philpownall/ESPHome-Sun-Moon-Azimuth-Tracker/docs/SunMoonTracker.png

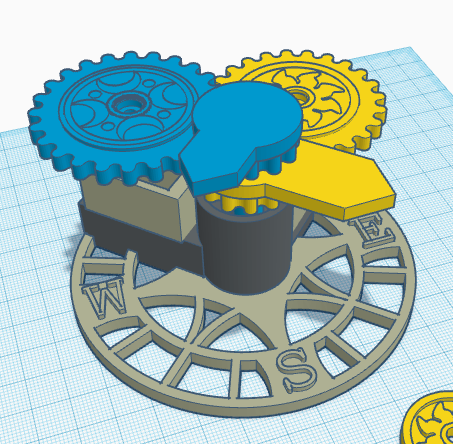
docs/SunMoonTracker.png
