philpownall/ESPHome-Sun-Moon-Azimuth-Tracker/README.md

# ESPHome-Sun-Moon-Azimuth-Tracker
 An Azimuth Tracker for the Sun and Moon

[SunMoonAzimuth.md](./docs/SunMoonAzimuth.md)
