philpownall/ESPHome-Sun-Moon-Azimuth-Tracker/2X Cog Sun.stl

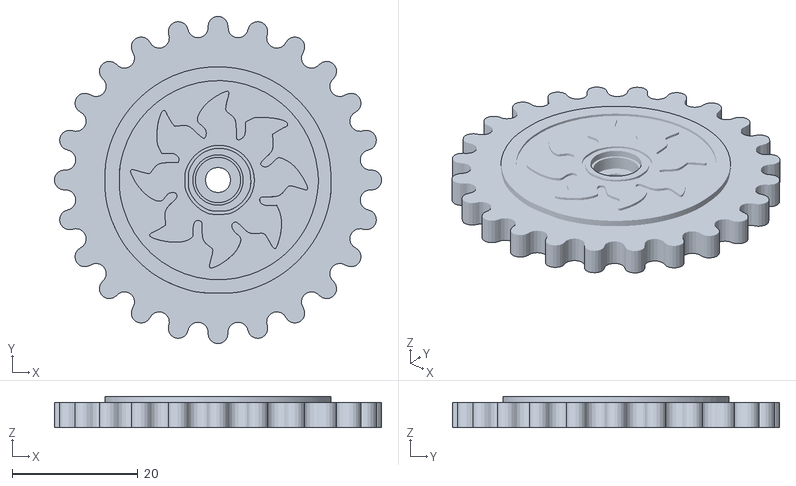
[picture p2: CAD file, 2024-05-20]
2X Cog Sun.stl
52.0 x 52.0 x 5.00
