philpownall/ESPHome-Sun-Moon-Azimuth-Tracker/Sun Cog.stl

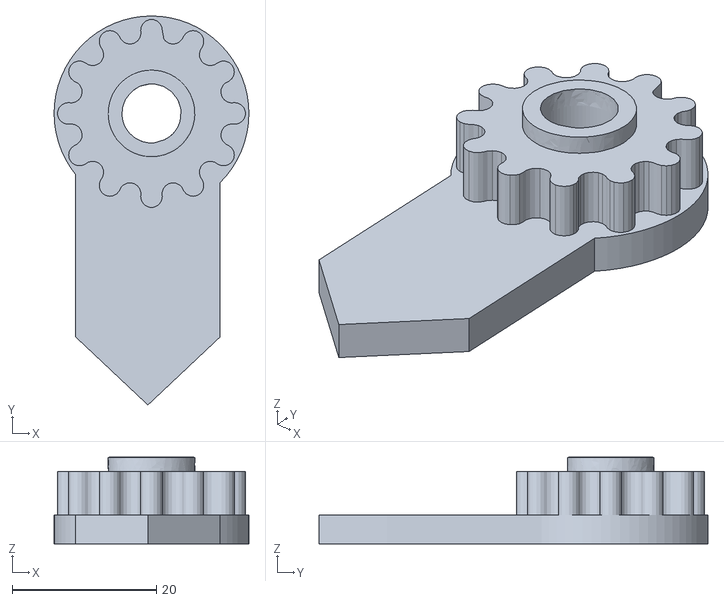
[picture p3: CAD file, 2024-05-20]
Sun Cog.stl
27.0 x 53.9 x 12.0
