philpownall/ESPHome-Sun-Moon-Azimuth-Tracker/2X Cog Moon.stl

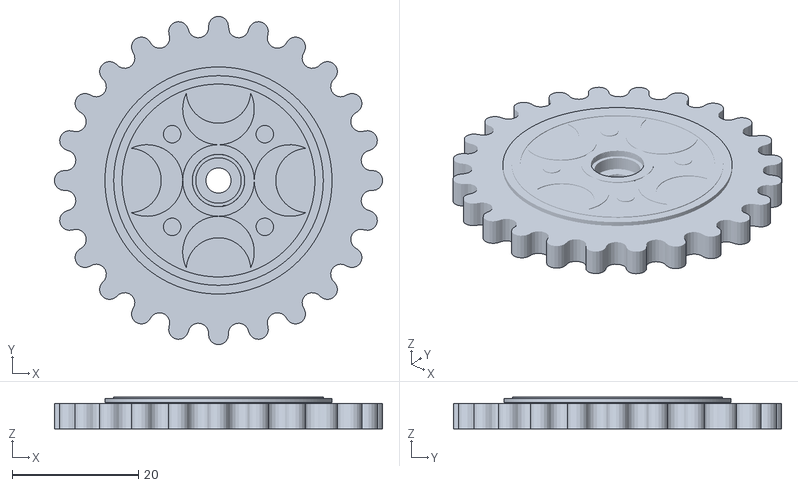
[picture p4: CAD file, 2024-05-20]
2X Cog Moon.stl
52.0 x 52.0 x 5.00
