philpownall/ESPHome-Sun-Moon-Azimuth-Tracker/SunMoonAz Base.stl

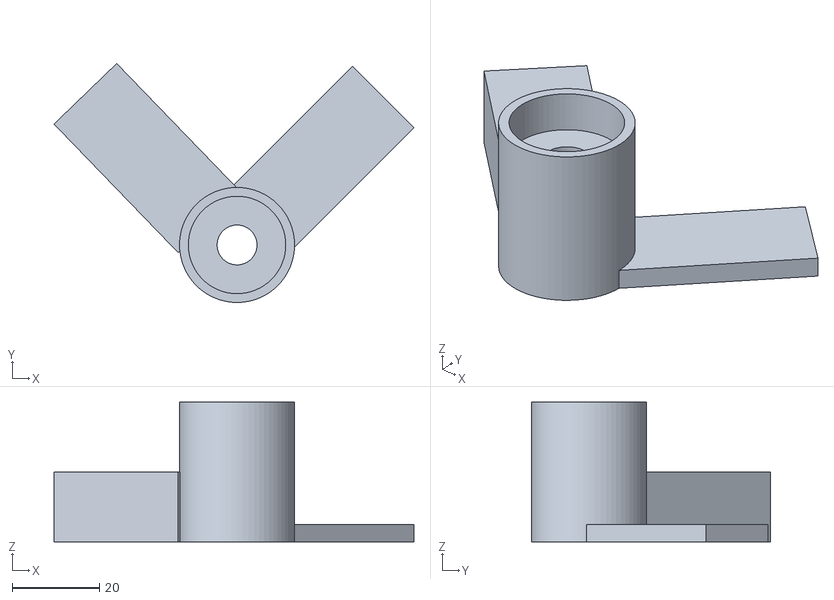
[picture p5: CAD file, 2024-05-20]
SunMoonAz Base.stl
82.6 x 54.8 x 32.0
