philpownall/ESPHome-Sun-Moon-Azimuth-Tracker/Moon Cog.stl

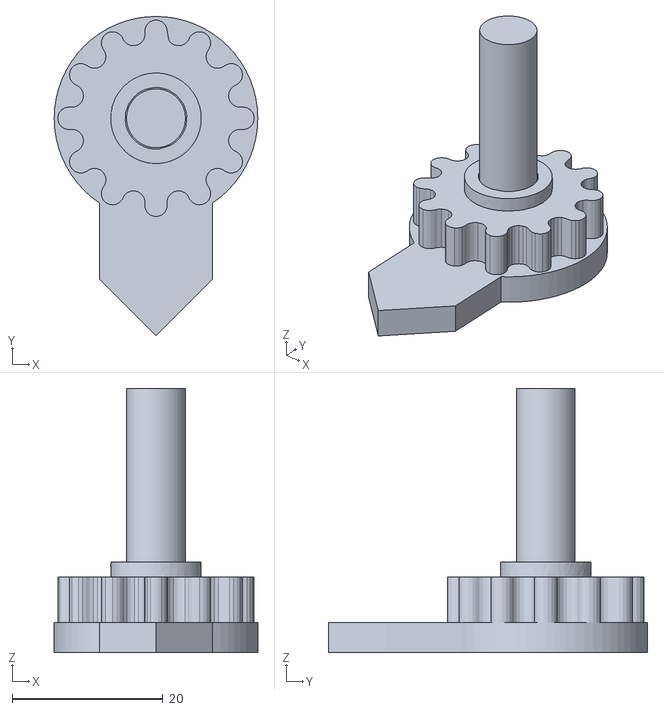
[picture p6: CAD file, 2024-05-20]
Moon Cog.stl
27.0 x 42.3 x 35.0
