philpownall/ESPHome-Sun-Moon-Azimuth-Tracker/(commit log)

2024-05-20 Initial Commit
    A Sun/Moon Azimuth Tracker
    [2X Cog Moon.stl, 2X Cog Sun.stl, Moon Cog.stl, Sun Cog.stl, SunMoonAz Base.stl]
2024-05-21 Corrected node name in yaml and docs
    [SunMoonAz.yaml]
